trishit90/drive-unit-library/cad/DriveUnit_V37.step

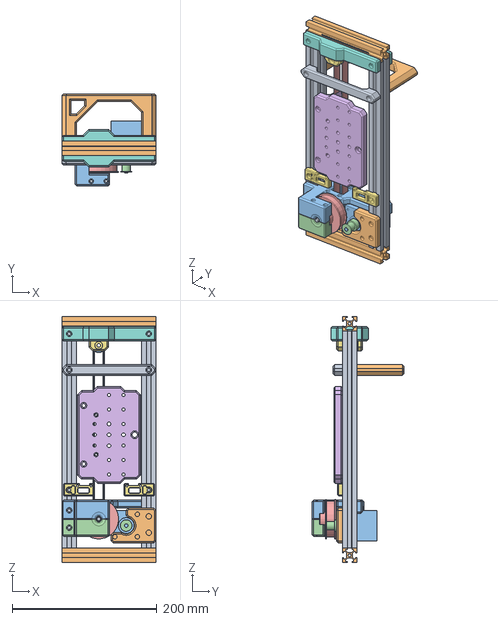
[picture p3: CAD file, 2026-10-15]
cad/DriveUnit_V37.step
130.0 x 127.0 x 340.0 mm
