trishit90/drive-unit-library/cad/DriveUnitV37STLs/BeltTightenerRight.3mf

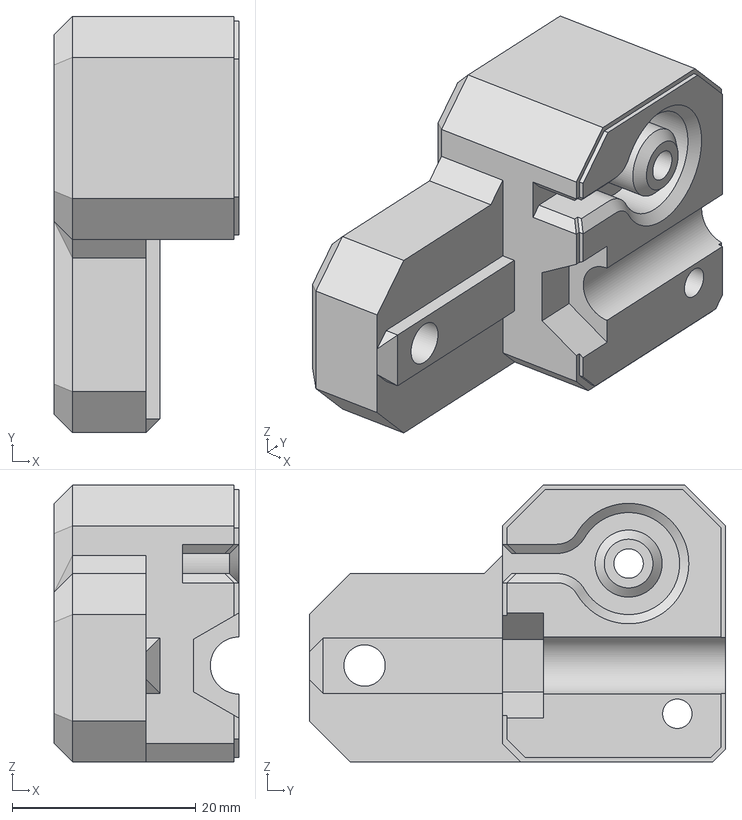
[picture p4: CAD file, 2026-10-15]
cad/DriveUnitV37STLs/BeltTightenerRight.3mf
20.1 x 45.3 x 30.1 mm
