trishit90/drive-unit-library/cad/DriveUnitV37STLs/PulleyStackHolderBottom.3mf

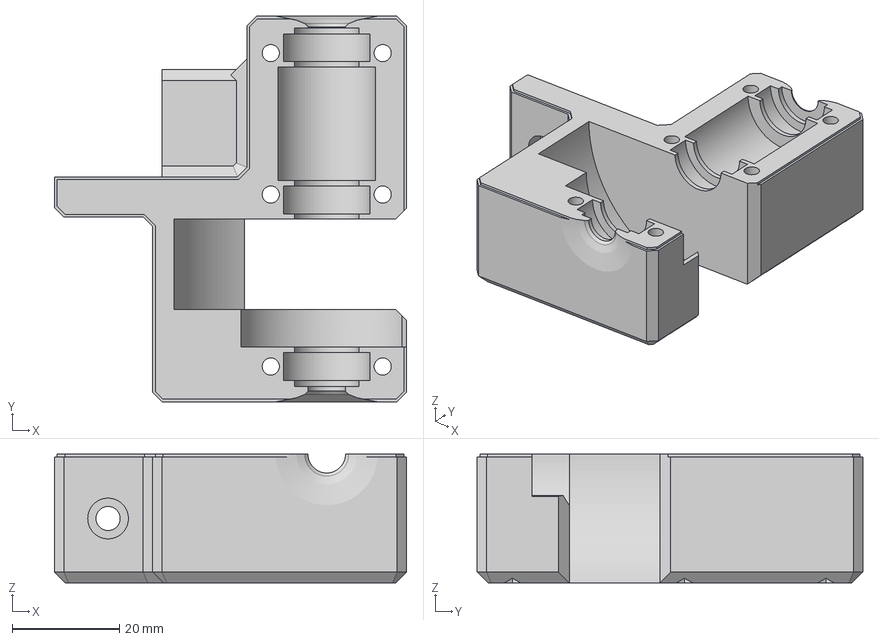
[picture p5: CAD file, 2026-10-15]
cad/DriveUnitV37STLs/PulleyStackHolderBottom.3mf
65.7 x 72.0 x 24.0 mm
