trishit90/drive-unit-library/cad/DriveUnitV37STLs/Carriage.3mf

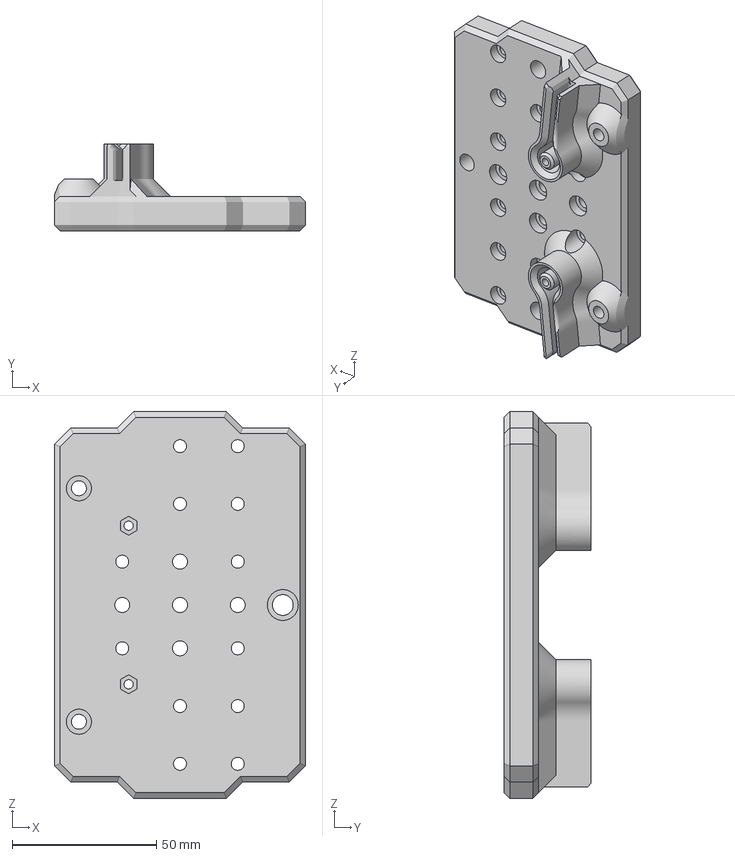
[picture p6: CAD file, 2026-10-15]
cad/DriveUnitV37STLs/Carriage.3mf
87.0 x 30.1 x 134.0 mm
