trishit90/drive-unit-library/cad/DriveUnitV37STLs/carriage2.3mf

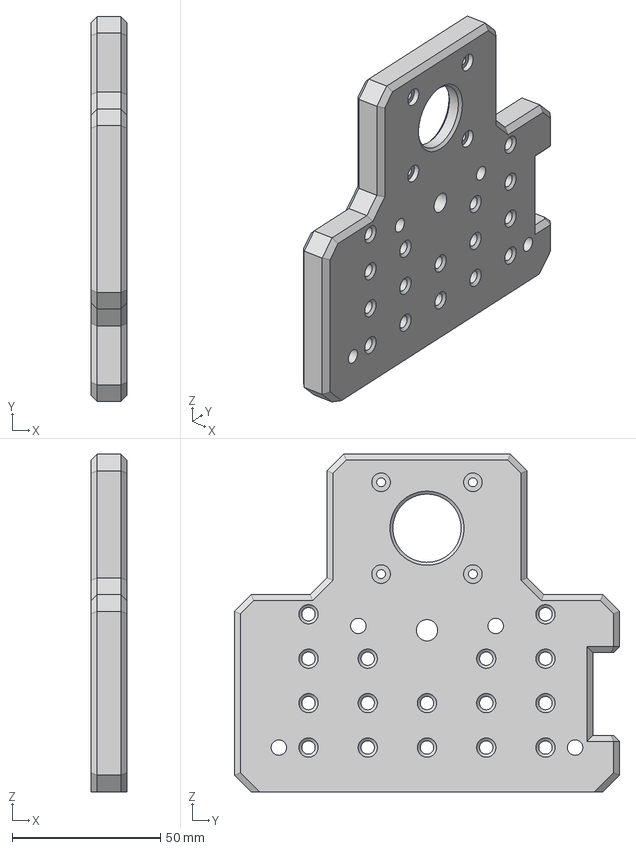
[picture p7: CAD file, 2026-10-15]
cad/DriveUnitV37STLs/carriage2.3mf
12.0 x 130.0 x 114.1 mm
