trishit90/drive-unit-library/cad/DriveUnitV37STLs/LimitSwitchRight.3mf

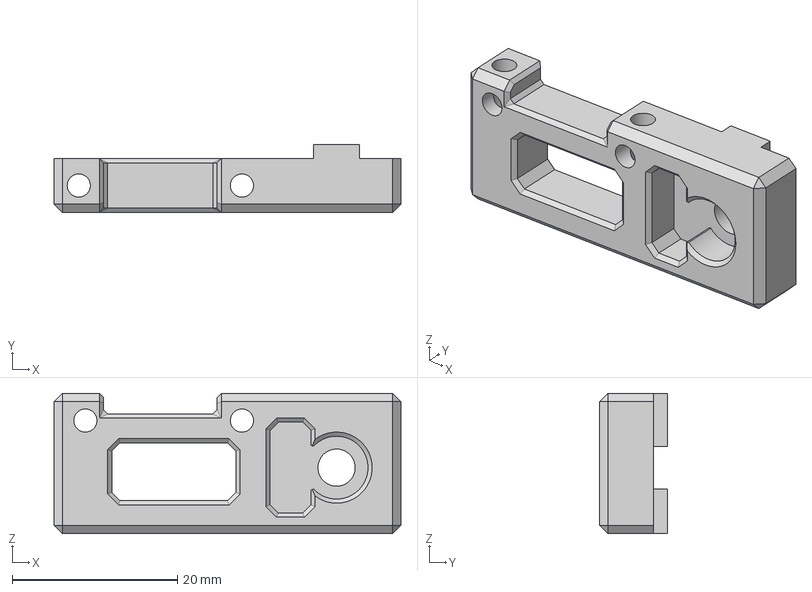
[picture p8: CAD file, 2026-10-15]
cad/DriveUnitV37STLs/LimitSwitchRight.3mf
42.0 x 8.20 x 17.0 mm
