trishit90/drive-unit-library/cad/DriveUnitV37STLs/stiffnerCableChain.3mf

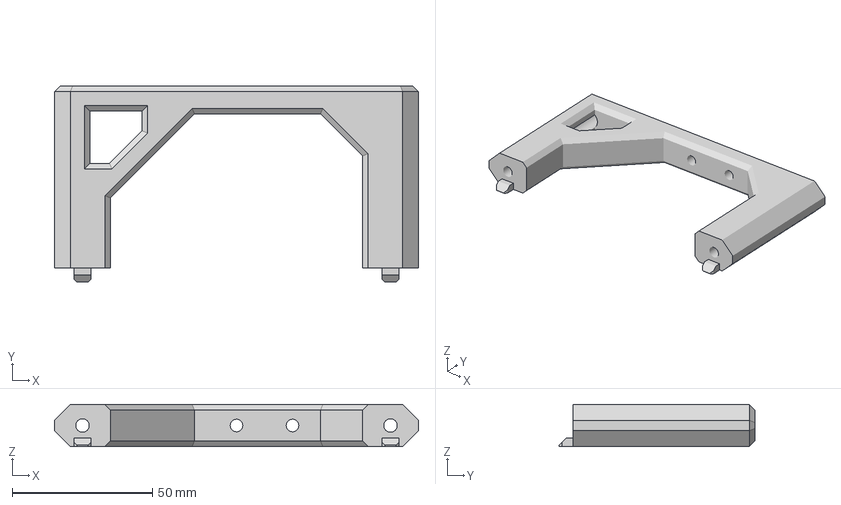
[picture p9: CAD file, 2026-10-15]
cad/DriveUnitV37STLs/stiffnerCableChain.3mf
130.0 x 70.0 x 15.0 mm
