trishit90/drive-unit-library/cad/DriveUnitV37STLs/beltTightner.3mf

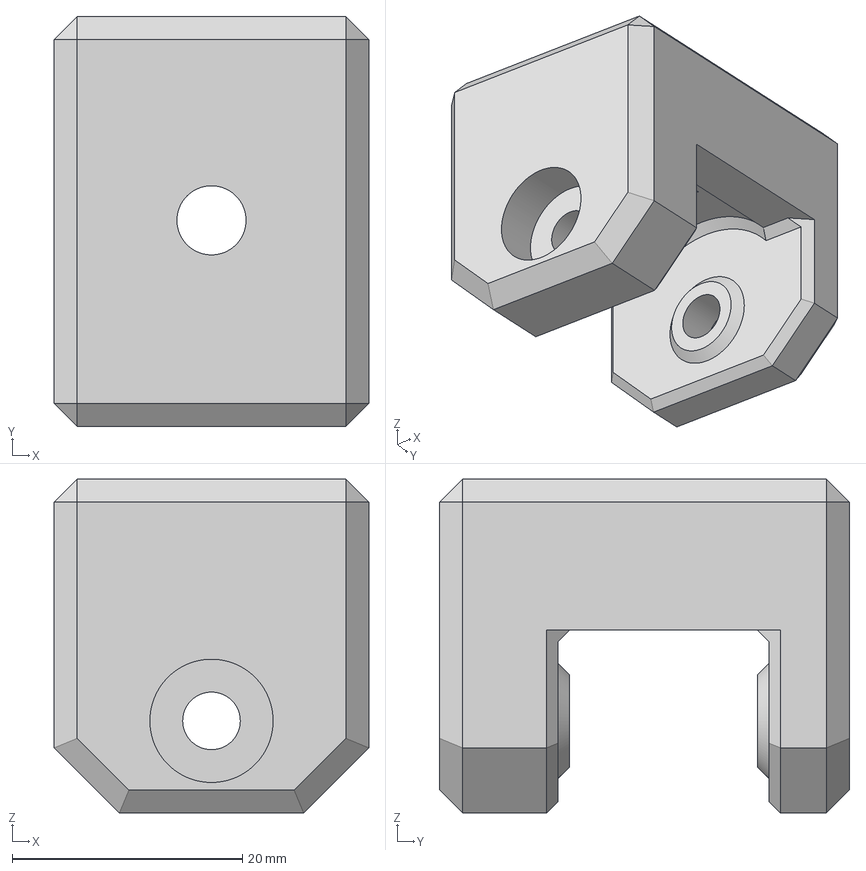
[picture p10: CAD file, 2026-10-15]
cad/DriveUnitV37STLs/beltTightner.3mf
27.3 x 35.6 x 29.0 mm
