trishit90/drive-unit-library/cad/DriveUnitV37STLs/M6Knob.3mf

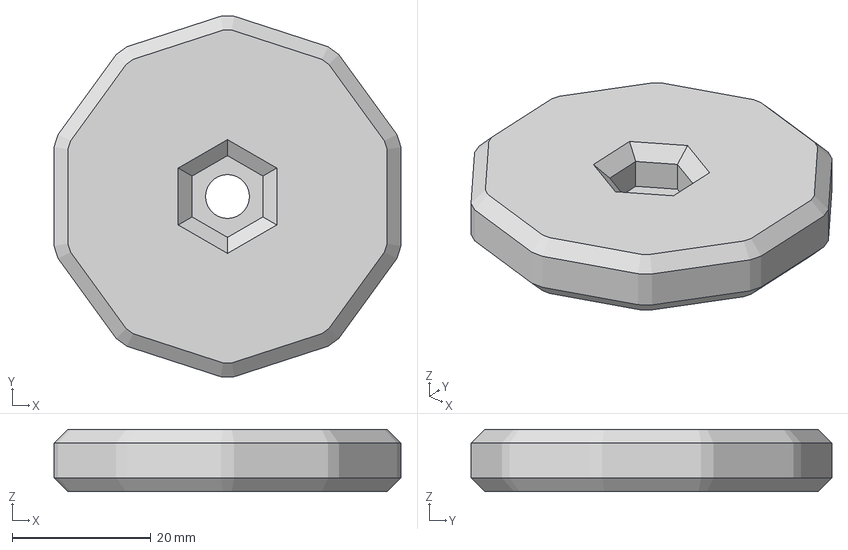
[picture p11: CAD file, 2026-10-15]
cad/DriveUnitV37STLs/M6Knob.3mf
50.0 x 52.0 x 9.00 mm
