trishit90/drive-unit-library/cad/DriveUnitV37STLs/pulleyBrace.3mf

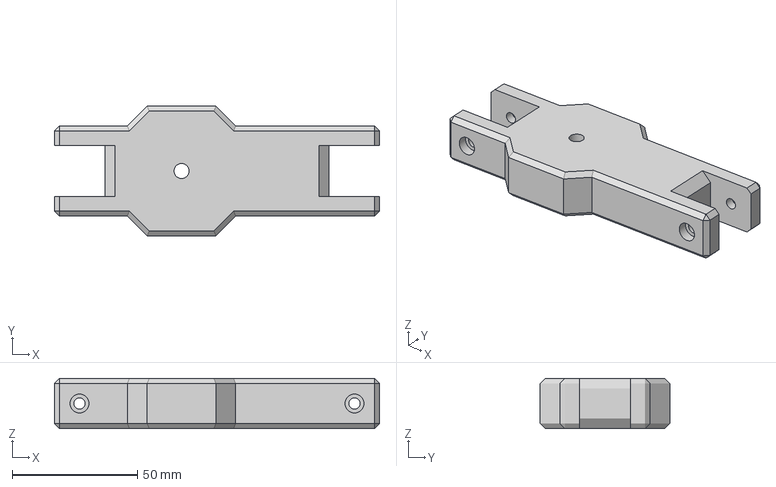
[picture p12: CAD file, 2026-10-15]
cad/DriveUnitV37STLs/pulleyBrace.3mf
130.0 x 51.8 x 20.0 mm
