trishit90/drive-unit-library/cad/DriveUnitV37STLs/cableChainMount.3mf

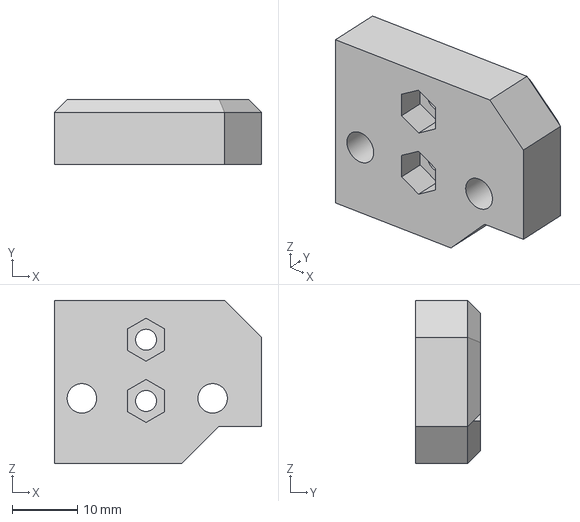
[picture p13: CAD file, 2026-10-15]
cad/DriveUnitV37STLs/cableChainMount.3mf
31.7 x 10.0 x 25.0 mm
