trishit90/drive-unit-library/cad/DriveUnitV37STLs/MotorBracket.3mf

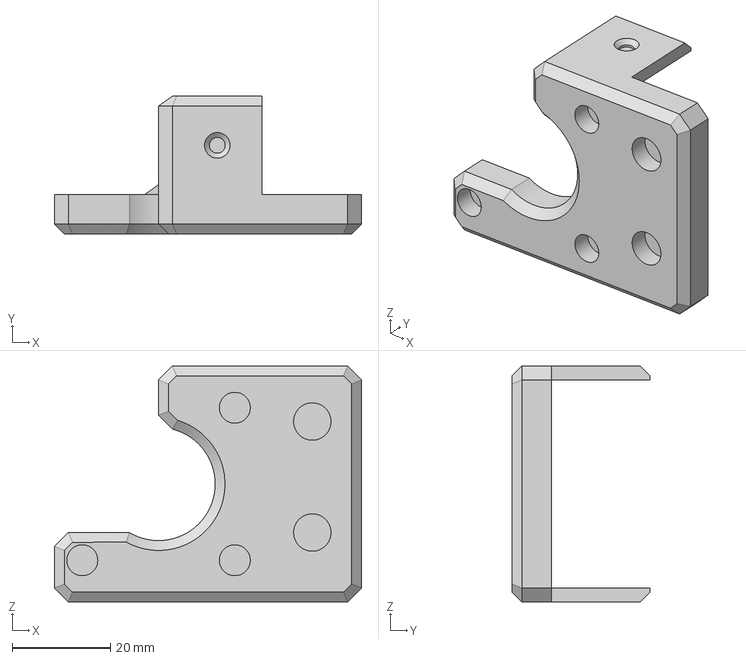
[picture p14: CAD file, 2026-10-15]
cad/DriveUnitV37STLs/MotorBracket.3mf
62.4 x 28.0 x 48.0 mm
