trishit90/drive-unit-library/cad/DriveUnitV37STLs/PulleyStackHolderTop.3mf

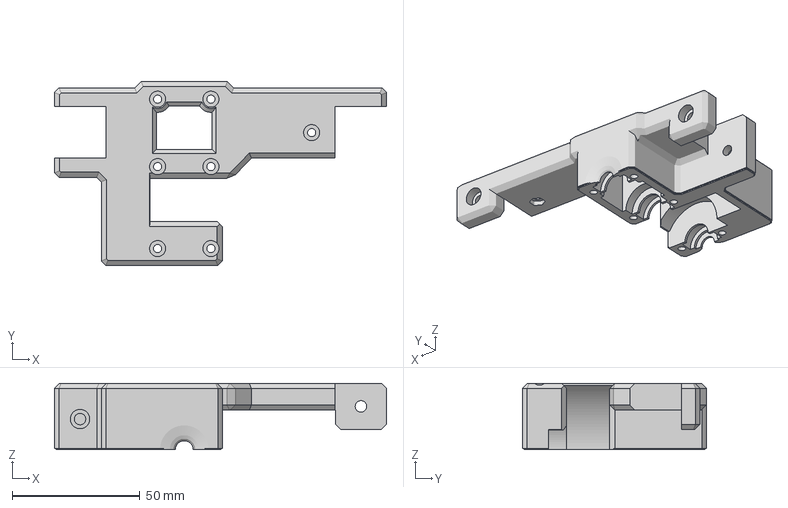
[picture p15: CAD file, 2026-10-15]
cad/DriveUnitV37STLs/PulleyStackHolderTop.3mf
130.0 x 72.0 x 26.0 mm
