trishit90/drive-unit-library/cad/DriveUnitV37STLs/DriveUnitGantry.3mf

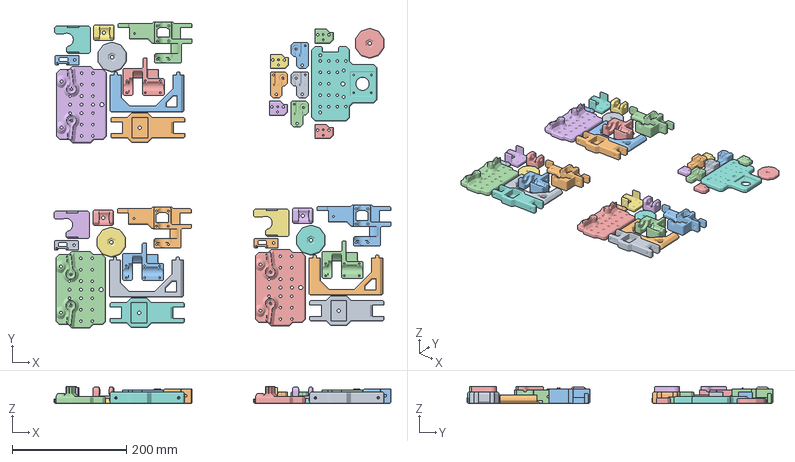
[picture p16: CAD file, 2026-10-15]
cad/DriveUnitV37STLs/DriveUnitGantry.3mf
590.5 x 536.0 x 30.1 mm
stiffnerCableChain x 3
PulleyStackHolderTop x 3
PulleyStackHolderBottom x 3
Carriage x 3
beltTightner x 3
MotorBracket x 3
M6Knob x 4
pulleyBrace x 3
LimitSwitchRight x 3
cableChainMount x 4
carriage2
BeltTightenerRight x 2
BeltTightenerLeft x 2
