trishit90/drive-unit-library/(list of files, cad)

Other CAD files:
cad/DriveUnitV37STLs/BeltTightenerLeft.3mf
cad/DriveUnitV37STLs/LimitSwitchLeft.3mf
