trishit90/drive-unit-library/cad/DriveUnitV37STLs/Print orientation.png

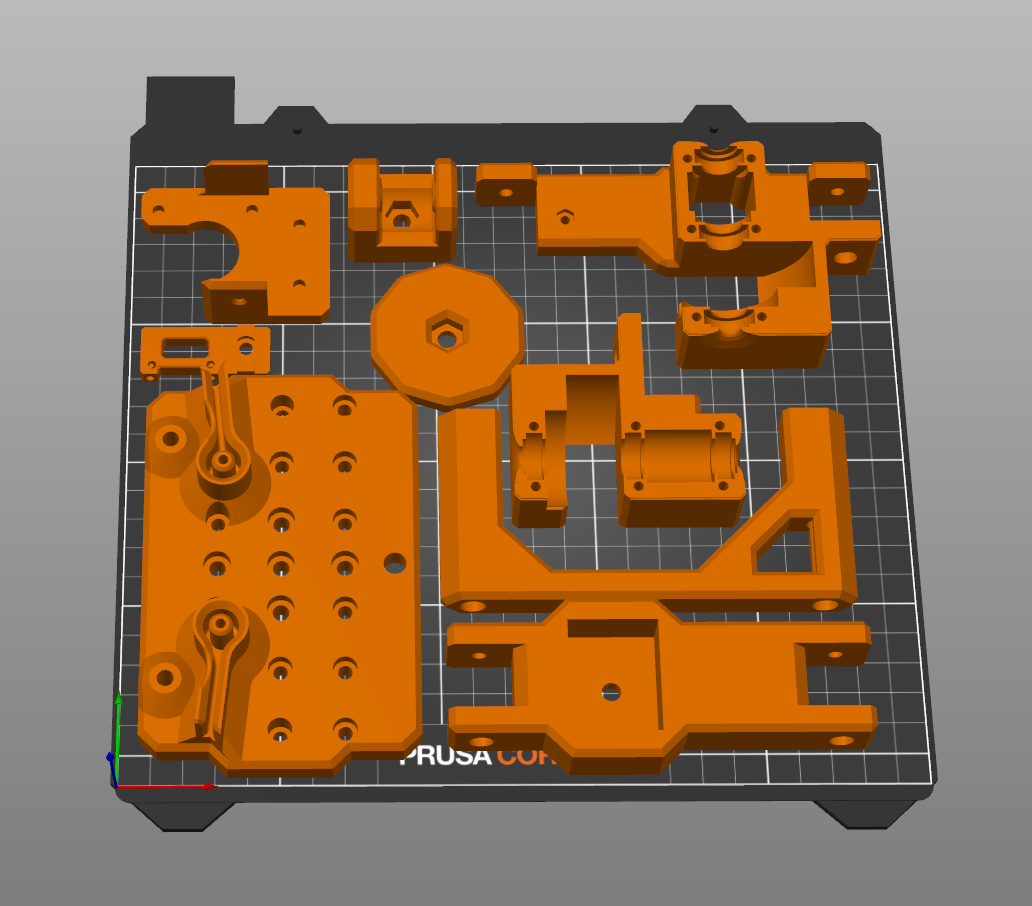
cad/DriveUnitV37STLs/Print orientation.png
