trishit90/drive-unit-library/(commit log)

2026-10-15 Add DriveUnit_V37 STEP model
    [DriveUnit_V37.step]
2026-10-15 Add CAD print files, software, firmware example, docs, guides, BOM, assembly guide and vibration data
    [BeltTightenerLeft.3mf, BeltTightenerRight.3mf, Carriage.3mf, DriveUnitGantry.3mf, LimitSwitchLeft.3mf, LimitSwitchRight.3mf, M6Knob.3mf, MotorBracket.3mf]
2026-10-15 CAD README: remove file-title and naming notes
